rLoopTeam/elec-node-core/rloopNodeCore.pdf

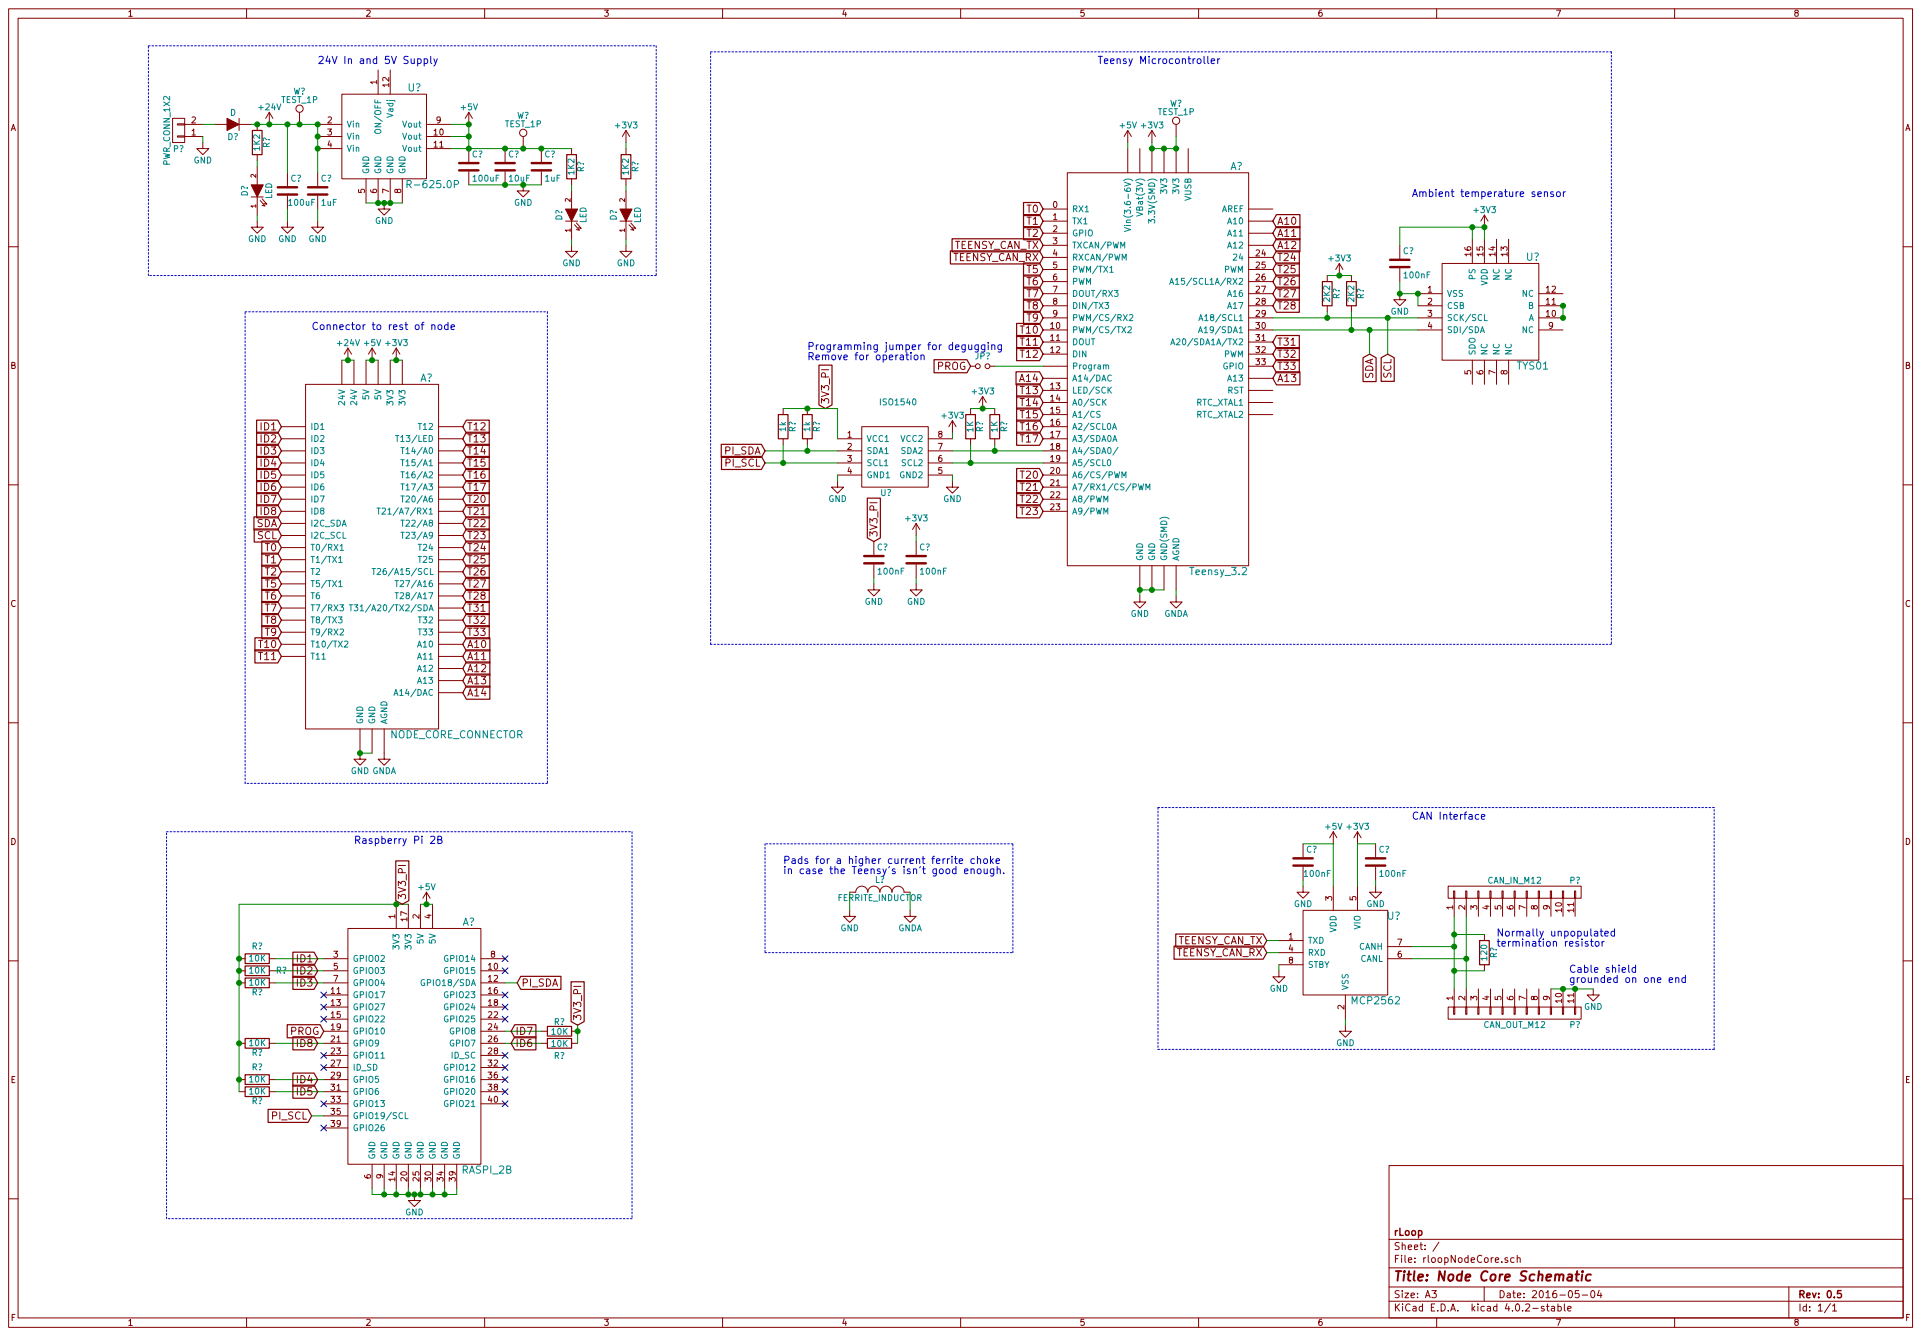
[picture p1: page 1]

AREF GND GND GND(SMD)

Connector to rest of node

Programming jumper for degugging
Remove for operation
TEENSY_CAN_RX 3V3_PI 3V3_PI

termination resistor SDA SCL 3V3_PI

A10 A11 A12 A13 A14/DAC GND GND AGND

L? FERRITE_INDUCTOR Pads for a higher current ferrite choke
in case the Teensy's isn't good enough.

Id: 1/1 Title: Node Core Schematic
