rLoopTeam/elec-node-core/rloopNodeCore.kicad_pcb

## KiCad design rloopNodeCore.kicad_pcb (2016-06-13)

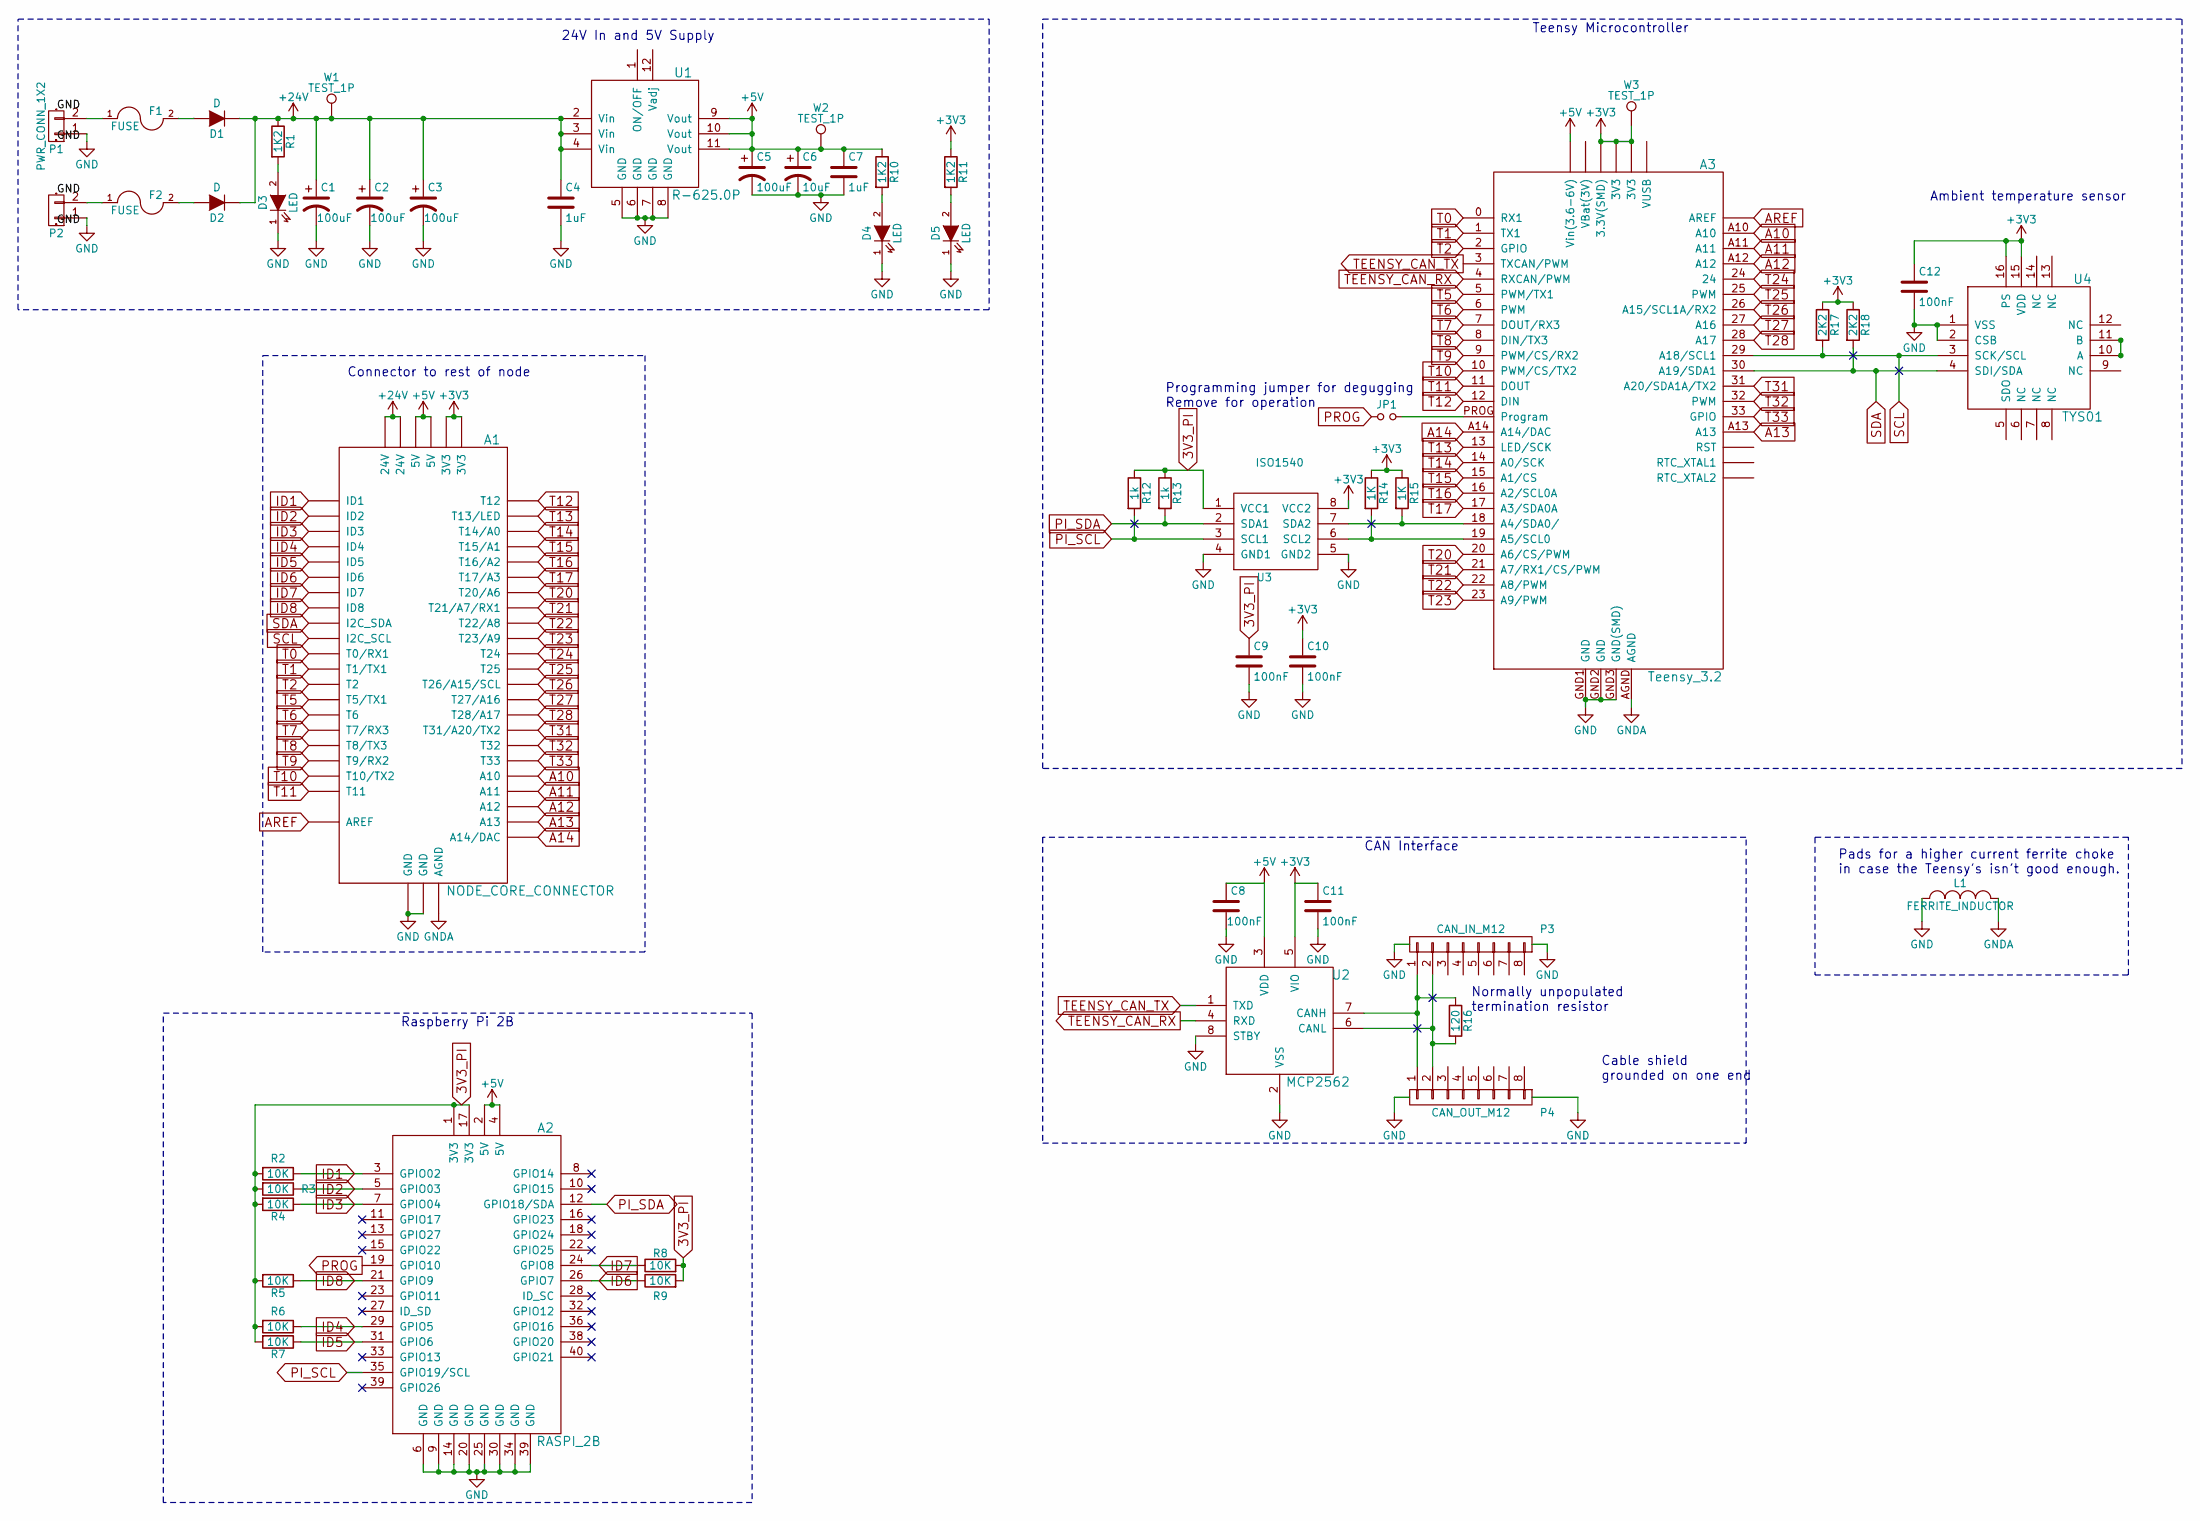
[picture p2: schematic rloopNodeCore.sch, Node Core Schematic]

Parts:
A1: NODE_CORE_CONNECTOR; NODECORE
A2: RASPI_2B; Pin_Header_Straight_2x20
A3: Teensy_3.2; TEENSY-3.2
C1, C2, C3, C5: 100uF; c_elec_6.3x5.8
C4: 1uF; C_1206
C6: 10uF; C_1206_HandSoldering
C7: 1uF; C_0603
C8, C9, C10, C11, C12: 100nF; C_0603
D1, D2: D; SMC_Standard
D3, D4, D5: LED; LED_0603
F1, F2: FUSE; FUSEHOLDER-BLADE-LITTELFUSE-153
JP1: Jumper_NO_Small; Pin_Header_Straight_1x02
L1: FERRITE_INDUCTOR; NR4018_HandSoldering
P1, P2: PWR_CONN_1X2; CONN-TE-MICROMNL-2-PTH-MALE-RGT
P3: CAN_IN_M12; M12-TE-5-2172077-2
P4: CAN_OUT_M12; M12-TE-5-2172077-2
R1, R10, R11: 1K2; R_0603
R2, R3, R4, R5, R6, R7, R8, R9: 10K; R_0603
R12, R13: 1k; R_0603
R14, R15: 1K; R_0603
R16: 120; R_1206_HandSoldering
R17, R18: 2K2; R_0603
U1: R-625.0P; R-6xxxP
U2: MCP2562; SOIC-8_3.9x4.9mm_Pitch1.27mm
U3: ISO1540; SOIC-8_3.9x4.9mm_Pitch1.27mm
U4: TYS01; QFN-16-1EP_4x4mm_Pitch0.65mm
W1, W2, W3: TEST_1P; Pin_Header_Straight_1x01

Connections:
3V3_PI: A2.1 (3V3), A2.17 (3V3), C9.1, R2.2, R3.2, R4.2, R5.2, R6.2, R7.2, R8.2, R9.2, R12.1, R13.1, U3.1 (VCC1)
+3V3: A1.+3V3 (3V3), A3.+3V3 (3.3V(SMD)), C10.1, C11.1, C12.1, R11.1, R14.1, R15.1, R17.1, R18.1, U2.5 (VIO), U3.8 (VCC2), U4.15 (VDD), U4.16 (PS), W3.1
+5V: A1.+5V (5V), A2.2 (5V), A2.4 (5V), A3.VIN (Vin(3.6-6V)), C5.1, C6.1, C7.1, C8.1, R10.1, U1.9 (Vout), U1.10 (Vout), U1.11 (Vout), U2.3 (VDD), W2.1
+24V: A1.+24V (24V), C1.1, C2.1, C3.1, C4.1, D1.1 (K), D2.1 (K), R1.1, U1.2 (Vin), U1.3 (Vin), U1.4 (Vin), W1.1
A10: A1.A10, A3.A10
A11: A1.A11, A3.A11
A12: A1.A12, A3.A12
A13: A1.A13, A3.A13
A14: A1.A14 (A14/DAC), A3.A14 (A14/DAC)
AREF: A1.AREF, A3.AREF
GND: A1.GND, A2.6 (GND), A2.9 (GND), A2.14 (GND), A2.20 (GND), A2.25 (GND), A2.30 (GND), A2.34 (GND), A2.39 (GND), A3.GND1 (GND), A3.GND2 (GND), A3.GND3 (GND(SMD)), C1.2, C2.2, C3.2, C4.2, C5.2, C6.2, C7.2, C8.2, C9.2, C10.2, C11.2, C12.2, D3.1 (K), D4.1 (K), D5.1 (K), L1.1, P1.1, P1.M1, P1.M2, P2.1, P2.M1, P2.M2, P3.M1, P3.M2, P4.M1, P4.M2, U1.5 (GND), U1.6 (GND), U1.7 (GND), U1.8 (GND), U2.2 (VSS), U2.8 (STBY), U3.4 (GND1), U3.5 (GND2), U4.1 (VSS), U4.2 (CSB)
GNDA: A1.AGND, A3.AGND, L1.2
ID1: A1.ID1, A2.3 (GPIO02), R2.1
ID2: A1.ID2, A2.5 (GPIO03), R3.1
ID3: A1.ID3, A2.7 (GPIO04), R4.1
ID4: A1.ID4, A2.29 (GPIO5), R6.1
ID5: A1.ID5, A2.31 (GPIO6), R7.1
ID6: A1.ID6, A2.26 (GPIO7), R9.1
ID7: A1.ID7, A2.24 (GPIO8), R8.1
ID8: A1.ID8, A2.21 (GPIO9), R5.1
unnamed: A3.18 (A4/SDA0/), R15.2, U3.7 (SDA2)
unnamed: A3.19 (A5/SCL0), R14.2, U3.6 (SCL2)
unnamed: A3.PROG (Program), JP1.2
unnamed: D1.2 (A), F1.2
unnamed: D2.2 (A), F2.2
unnamed: D3.2 (A), R1.2
unnamed: D4.2 (A), R10.2
unnamed: D5.2 (A), R11.2
unnamed: F1.1, P1.2
unnamed: F2.1, P2.2
unnamed: P3.1, P4.1, R16.1, U2.7 (CANH)
unnamed: P3.2, P4.2, R16.2, U2.6 (CANL)
unnamed: U4.10 (A), U4.11 (B)
PI_SCL: A2.35 (GPIO19/SCL), R12.2, U3.3 (SCL1)
PI_SDA: A2.12 (GPIO18/SDA), R13.2, U3.2 (SDA1)
PROG: A2.19 (GPIO10), JP1.1
SCL: A1.T29 (I2C_SCL), A3.29 (A18/SCL1), R17.2, U4.3 (SCK/SCL)
SDA: A1.T30 (I2C_SDA), A3.30 (A19/SDA1), R18.2, U4.4 (SDI/SDA)
T0: A1.T0 (T0/RX1), A3.0 (RX1)
T1: A1.T1 (T1/TX1), A3.1 (TX1)
T2: A1.T2, A3.2 (GPIO)
T5: A1.T5 (T5/TX1), A3.5 (PWM/TX1)
T6: A1.T6, A3.6 (PWM)
T7: A1.T7 (T7/RX3), A3.7 (DOUT/RX3)
T8: A1.T8 (T8/TX3), A3.8 (DIN/TX3)
T9: A1.T9 (T9/RX2), A3.9 (PWM/CS/RX2)
T10: A1.T10 (T10/TX2), A3.10 (PWM/CS/TX2)
T11: A1.T11, A3.11 (DOUT)
T12: A1.T12, A3.12 (DIN)
T13: A1.T13 (T13/LED), A3.13 (LED/SCK)
T14: A1.T14 (T14/A0), A3.14 (A0/SCK)
T15: A1.T15 (T15/A1), A3.15 (A1/CS)
T16: A1.T16 (T16/A2), A3.16 (A2/SCL0A)
T17: A1.T17 (T17/A3), A3.17 (A3/SDA0A)
T20: A1.T20 (T20/A6), A3.20 (A6/CS/PWM)
T21: A1.T21 (T21/A7/RX1), A3.21 (A7/RX1/CS/PWM)
T22: A1.T22 (T22/A8), A3.22 (A8/PWM)
T23: A1.T23 (T23/A9), A3.23 (A9/PWM)
T24: A1.T24, A3.24
T25: A1.T25, A3.25 (PWM)
T26: A1.T26 (T26/A15/SCL), A3.26 (A15/SCL1A/RX2)
T27: A1.T27 (T27/A16), A3.27 (A16)
T28: A1.T28 (T28/A17), A3.28 (A17)
T31: A1.T31 (T31/A20/TX2), A3.31 (A20/SDA1A/TX2)
T32: A1.T32, A3.32 (PWM)
T33: A1.T33, A3.33 (GPIO)
TEENSY_CAN_RX: A3.4 (RXCAN/PWM), U2.4 (RXD)
TEENSY_CAN_TX: A3.3 (TXCAN/PWM), U2.1 (TXD)

Notes on the sheet:
Pads for a higher current ferrite choke in case the Teensy's isn't good enough.
Programming jumper for degugging Remove for operation
Ambient temperature sensor
Cable shield grounded on one end
CAN Interface
Raspberry Pi 2B
24V In and 5V Supply
Connector to rest of node
Normally unpopulated termination resistor
Teensy Microcontroller

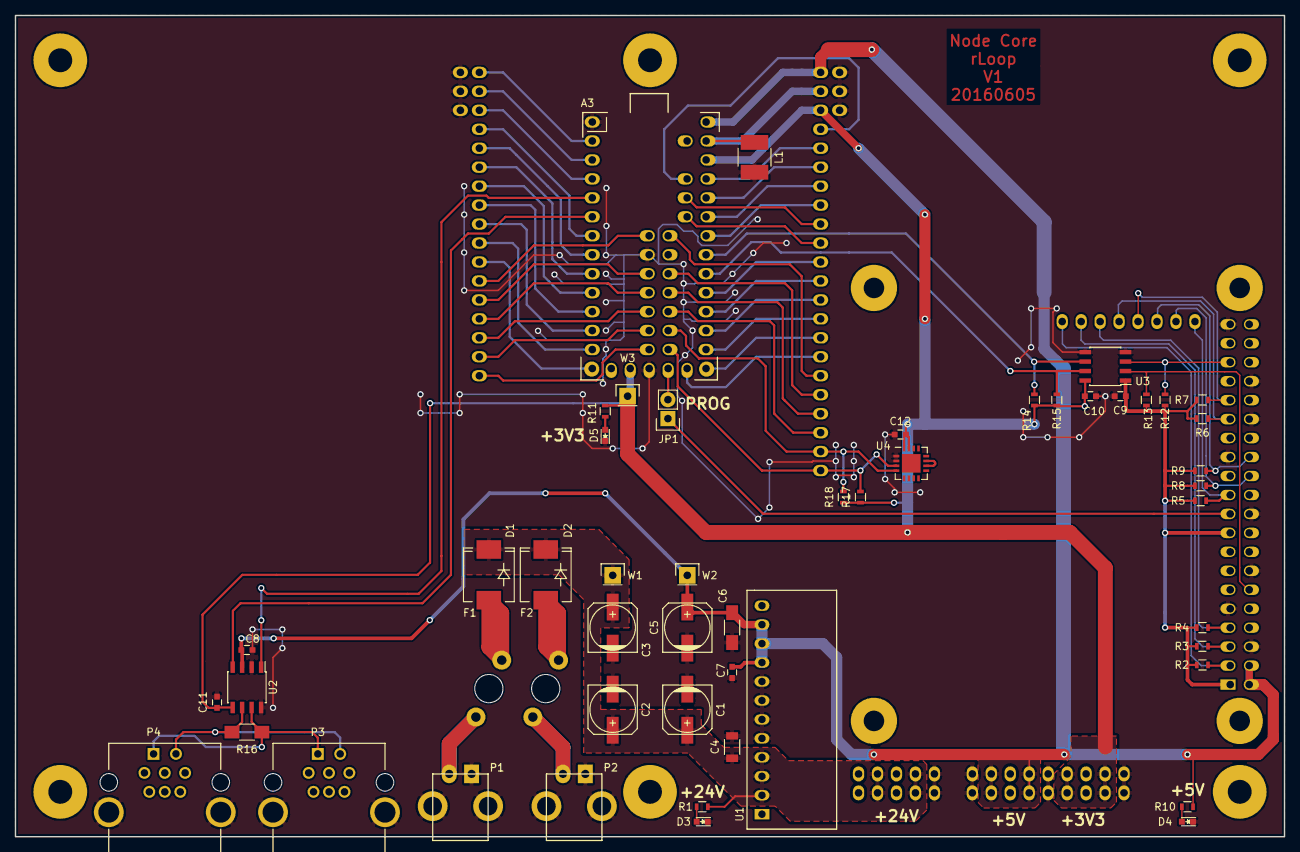
[picture p3: board rloopNodeCore.kicad_pcb from above]

Board: 2 copper layers, 170.0 x 110.0 mm, 53 parts (1 on the bottom side), 68 nets.
