rLoopTeam/elec-node-core/(commit log)

2016-04-28 First draft!
    [rloopNodeCore.sch]
2016-05-05 v0.2
    Added I2C isolator
    Added 24V input diode
    Added power rail test points and indicator LEDs
    More power supply filter caps
    [rloopNodeCore.sch]
2016-05-08 v0.3
    Added optional ferrite choke between GND and AGND
    Isolated I2C transceiver supply voltages
    Removed CAN from Node Core Connector
    Added program pin jumper
    [rloopNodeCore.sch]
2016-05-09 Formatting Improvements
    [rloopNodeCore.sch]
2016-05-16 just seeing how big everything is
    [rloopNodeCore.kicad_pcb, rloopNodeCore.sch]
2016-06-06 node core is almost done, awaiting review
    [rloopNodeCore.kicad_pcb, rloopNodeCore.sch]
2016-06-12 minor routing changes, some more vias
    [rloopNodeCore.kicad_pcb]
2016-06-13 F2 was offset by a single hair
    [rloopNodeCore.kicad_pcb]
2016-06-13 recovered lost ground traces
    [rloopNodeCore.kicad_pcb]
